addrummond/newlightmeter/kischematic/Readme.md

PChan MOSFET http://www.mouser.co.uk/ProductDetail/ROHM-Semiconductor/RZM001P02T2L/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
NChan http://www.mouser.co.uk/ProductDetail/ROHM-Semiconductor/RE1C002UNTCL/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

Low freq crystal: NX3215SA
High (16MHz) freq crystal: NX3225SA

USB-C connector protrusion above top layer: 0.475
USB-C connector protrusion above bottom layer: 2.265
USB-C total height: 3.34

EFM32 height: 0.85
BlueNRG-MS height: 0.85
BQ2971 height: 0.8
MMA8653FC height: 1.0
APDS-9303 height: 0.55
TPS62230: 0.65
Skyworks thing: 0.75
Inductor height: 1.0
Antenna height: 1.07
Dual MOSFET height: 0.9
EZMate thing: 1.4
Screen: 1.45
Zif connector height: 2
Low freq crystal: 0.9
High freq crystal: 0.55

Newest pair of crystals (available on Mouser):
http://www.mouser.co.uk/Search/ProductDetail.aspx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
http://www.mouser.co.uk/Search/ProductDetail.aspx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

Magic micro:

http://www.silabs.com/support%20documents/technicaldocs/efm32hg309.pdf

Suitable flat flex cable (cut in half):

http://www.digikey.co.uk/product-detail/en/molex-llc/0152660073/WM11348-ND/3160809

Side mount switch:

http://uk.rs-online.com/web/p/products/7856443/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|pcrid|88057077243|pkw||pmt||prd|7856443&gclid=Cj0KEQiAnIPDBRC7t5zJs4uQu5UBEiQA7u5Nez5Wsqkz7oU2pIy9AWAJCai1eRbfQIoq8IcizyYJO9QaAkB28P8HAQ

Useful info on EFM32 3-wire SPI:

http://community.silabs.com/t5/32-bit-MCU-Knowledge-Base/EFM32-as-a-3-wire-SPI-master/ta-p/123022

New dual MOSFET:

http://www2.mouser.com/ProductDetail/Infineon-Technologies/BSD840NH6327XTSA1/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

New buck:

http://www2.mouser.com/ProductDetail/Texas-Instruments/TPS62237DRYR/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

Low profile shileded inductor (1.0mm):

http://www2.mouser.com/ProductDetail/Bourns/SRP2010-1R0M/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

Old shielded inductor:

http://www2.mouser.com/ProductDetail/Sumida/CDRH2D18-HPNP-100NC/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
http://www.mouser.com/ds/2/390/cdrh2d18hp-339282.pdf

Old buck:

http://www2.mouser.com/ProductDetail/Texas-Instruments/LM3670MF-33-NOPB/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

USB-C midmount connector:

http://www.farnell.com/cad/1993947.pdf?_ga=1.47058095.988751352.1481488664

Notes on USB C configuration:

https://www.scorpia.co.uk/2016/03/17/using-usb-type-c-on-hobyist-projects/

3.2V LDO:

http://www2.mouser.com/ProductDetail/ROHM-Semiconductor/BU32TD3WG-TR/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

Little pogo pins:

http://www.digikey.co.uk/product-detail/en/mill-max-manufacturing-corp/0921-1-15-20-75-14-11-0/ED1655-ND/2784010

Trace impedance calc:

http://emclab.mst.edu/pcbtlc2/microstrip/

Trace thickness: 0.03556
Relative permittivity: 4.8
