addrummond/newlightmeter/bluenrg_notes/Readme.md

Some random notes on the BlueNRG and its SPI interface.

Start of a command packet signaled with 01.
Start of an event packet signaled with 04.

Some evidence that "04 0e 04 01 0c fc 00" is a normal response upon setting
device address:

<<<<<<< HEAD
    http://bbs.csdn.net/topics/391021421
=======
    https://www.google.co.uk/webhp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

Potentially useful info on correct sequence of startup commands (although
this is presumably being posted because it doesn't quite work):

http://bbs.csdn.net/topics/391021421

>>>>>>> 2c90545d739c9cc67405625468b59055c7635256
