addrummond/newlightmeter/kischematic/shopping.txt

5
http://www.mouser.co.uk/ProductDetail/Murata-Electronics/GRM155R60G106ME44D/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

3
http://www.mouser.co.uk/ProductDetail/TDK/C0402C0G1C470J020BC/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

17
http://www.mouser.co.uk/ProductDetail/AVX/01016D104KATUA/?qs=sGAEpiMZZMs0AnBnWHyRQAwkDkDzLNakJDHmuCcZvLc%3d

3
http://www.mouser.co.uk/ProductDetail/Kemet/C0402C103K8PACTU/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

1
http://www.mouser.co.uk/ProductDetail/AVX/02016D105KAT2A/?qs=sGAEpiMZZMs0AnBnWHyRQHzHPE94NOakZzFL8rkwtwk%3d

5
http://www.mouser.co.uk/ProductDetail/Taiyo-Yuden/AMK105BJ475MV-F/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

2
http://www.mouser.co.uk/ProductDetail/Taiyo-Yuden/JMK105BJ105MC-F/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

2
http://www.mouser.co.uk/ProductDetail/Wurth-Electronics/885012105012/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

1
http://www.mouser.co.uk/ProductDetail/AVX/04026D225KAT2A/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

2
http://www.mouser.co.uk/Search/ProductDetail.aspx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

2
http://www.mouser.co.uk/ProductDetail/Kemet/C0402C560J5GACTU/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

2
http://www.mouser.co.uk/ProductDetail/Wurth-Electronics/885012005056/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

2
http://www.mouser.co.uk/ProductDetail/Wurth-Electronics/885012005027/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

1
http://www.mouser.co.uk/ProductDetail/Murata-Electronics/GRM155R71C154KA12D/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

2
http://www.mouser.co.uk/ProductDetail/Wurth-Electronics/885012205055/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

4
http://www.mouser.co.uk/ProductDetail/Wurth-Electronics/885012105012/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

1
http://www.mouser.co.uk/ProductDetail/TE-Connectivity/2129691-1/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

3
http://www.mouser.co.uk/ProductDetail/Vishay/CRCW04020000Z0ED/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

1
http://www.mouser.co.uk/ProductDetail/FTDI/FT200XD-R/?qs=sGAEpiMZZMvVkErl6zY%252bqaOuKzgOTT%2fR

2
http://www.mouser.co.uk/ProductDetail/Yageo/RT0402FRE0727RL/?qs=sGAEpiMZZMtlubZbdhIBILzAkmRldA9hfCto7XdLxWU%3d

2
http://www.mouser.co.uk/ProductDetail/Yageo/RC0402FR-0710KL/?qs=sGAEpiMZZMtlubZbdhIBIPp9I5DmXL4oTFYHT01xAts%3d

1
http://uk.rs-online.com/web/p/tactile-switches/7856443/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

1
http://www.mouser.co.uk/ProductDetail/Panasonic/ERJ-2RKF2201X/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

3
http://www.mouser.co.uk/ProductDetail/Panasonic/ERJ-2RKF9102X/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

1
http://www.mouser.co.uk/ProductDetail/Infineon-Technologies/BSD840NH6327XTSA1/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

1
http://www.mouser.co.uk/ProductDetail/Texas-Instruments/BQ29702DSER/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

1
http://www.mouser.co.uk/ProductDetail/Texas-Instruments/TPS62237DRYR/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

1
http://www.mouser.co.uk/Search/ProductDetail.aspx?R=SRP2010-2R2Mvirtualkey65210000virtualkey652-SRP2010-2R2M

2
http://www.mouser.co.uk/ProductDetail/Murata-Electronics/LQP02HQ1N3C02E/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

1
http://www.mouser.co.uk/ProductDetail/Coilcraft/0603CS-5N6XJLU/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

2
http://www.mouser.co.uk/ProductDetail/Coilcraft/0603CS-3N9XGLU/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

**** TODO TRY TO FIND CHEAPER
1
http://www.mouser.co.uk/Search/ProductDetail.aspx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

4
http://www.mouser.co.uk/ProductDetail/Panasonic/ERJ-2RKF1001X/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

1
http://www.mouser.co.uk/ProductDetail/Silicon-Labs/EFM32ZG108F8-QFN24/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

1
http://www.mouser.co.uk/ProductDetail/CK-Components/KXT-131-LHS/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

2
http://www.mouser.co.uk/ProductDetail/Broadcom-Limited/APDS-9303-020/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

1
http://www.mouser.co.uk/ProductDetail/NXP-Freescale/MMA8653FCR1/?qs=sGAEpiMZZMuJJ6wbRIs2btaRRQKJJnyc

1
http://www.mouser.co.uk/ProductDetail/TE-Connectivity-Neohm/CPF0402B2K2E1/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

1
http://www.mouser.co.uk/ProductDetail/TE-Connectivity-Neohm/CPF0402B330RE1/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

1
http://www.mouser.co.uk/ProductDetail/Vishay/CRCW04022M70FKED/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

1
http://www.mouser.co.uk/ProductDetail/Vishay/CRCW04021M60FKED/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

1
http://www.mouser.co.uk/ProductDetail/STMicroelectronics/BLUENRG-MSQTR/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

1
http://www.mouser.co.uk/ProductDetail/Taiyo-Yuden/CBMF1608T4R7M/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

1
http://www.mouser.co.uk/ProductDetail/ABRACON/ABM3B-16000MHZ-10-1-U-T/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

1
http://www.mouser.co.uk/ProductDetail/ECS/ECS-327-125-34B-TR/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

1
http://www.mouser.co.uk/ProductDetail/Murata-Electronics/NCP18XH103F03RB/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

1
http://www.mouser.co.uk/ProductDetail/Panasonic/DZ2S068M0L/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

2
http://www.mouser.co.uk/ProductDetail/Wurth-Electronics/885012005011/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

*** NON STOCK ***
1
http://www.mouser.co.uk/ProductDetail/Skyworks/AAT3672IWO-42-1-T1/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
