addrummond/newlightmeter/kischematic/kischematic.kicad_pcb

## KiCad design kischematic/kischematic.kicad_pcb (2017-08-05)

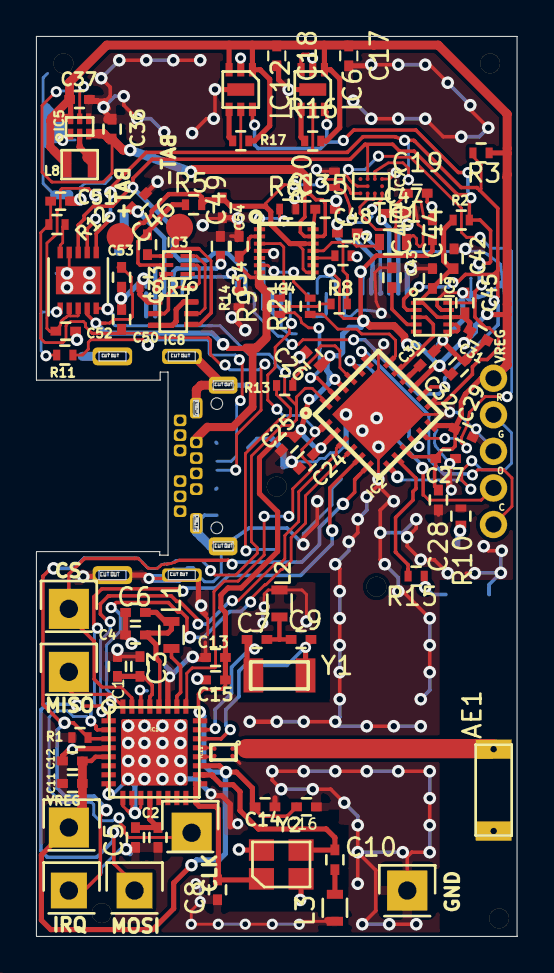
[picture p1: board kischematic.kicad_pcb from above]

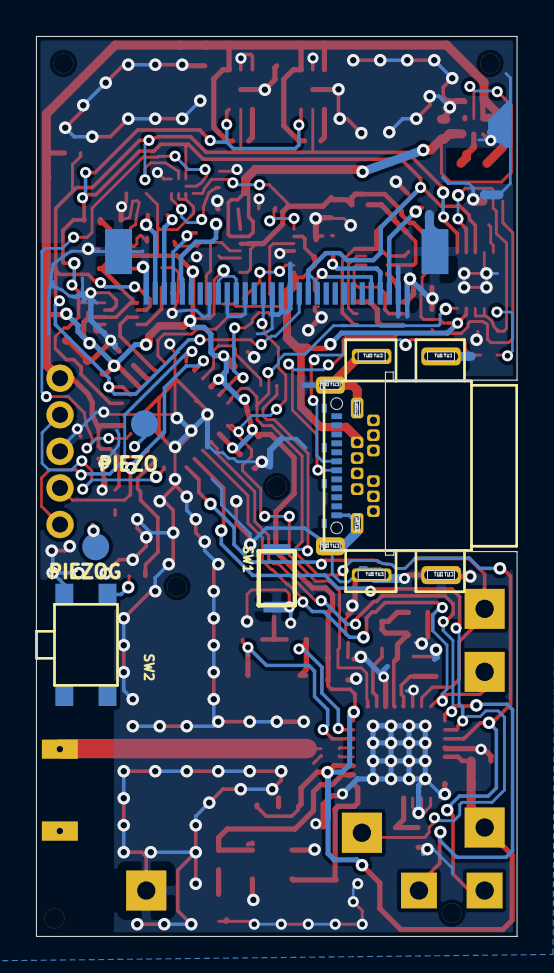
[picture p2: board kischematic.kicad_pcb from below]

Board: 2 copper layers, 26.7 x 50.0 mm, 108 parts (6 on the bottom side), 69 nets.

Parts:
AE1: Antenna_Dipole; AN2051
C1, C2: BY100p; C_0402
C3: BY150n; C_0402
C4: BY100n; C_0402
C5, C12, C14, C15: BYu1; C_0402
C6, C11, C13, C16: BY1u; C_0402
C7, C9: HP22p; C_0402
C8, C10: HP15p; C_0402
C17, C18, C19, C24, C26, C32, C33, C35, C43, C44, C45: u1; C_0402
C25, C28, C31, C34, C54: 10u; C_0402
C27, C29, C53: 10n; C_0402
C30, C42: 1u; C_0402
C36: BY 4u7; C_0402
C37: DC-DC 4u7; C_0402
C40, C47, C48: DC-DC 1u; C_0402
C46: DC-DC 2u2; C_0402
C49: 2u2; C_0402
C50, C51: 47p; C_0402
C52: 100n; C_0402
IC1: BlueNRG; QFN32
IC2: EFM32ZG108; QFN24
IC3: BQ297xx; WSON6
IC4: AAT3672IWO-4.2-1; AAT3672IWO
IC5: TPS6223xx
IC6, IC12: MAX44009
IC7: STC3115; STC3115IJT
IC8: BSD840NH6327XTSA1; SOT-363
IC9: MMA8653FC; DFN10
IC10: 128x64OLED; ER-OLED096-1
IC11: BALF-BRG-01D3; BALF-NRG-01D3
J1, J2, J3, J4, J5, J6: Screw_Terminal_1x01; M1.4MOUNTHOLE
L1: DC-DC 4u7; R_0603
L2, L3: 3n9; R_0603
L8: DC-DC 1u; SRP2010
P1, P2, P3, P4, P5, P6, P7: CONN_01X01; Pin_Header_Straight_1x01
R1, R8, R16, R17: 10k; R_0402
R2, R3, R13, R15: 1k; R_0402
R4: 2k2%; R_0402
R5: 330%; R_0402
R6: 2M7%; R_0402
R7: 1M6%; R_0402
R9, R11, R12, R21: 27R; R_0402
R10: 2k2; R_0402
R14: 91k; R_0402
R20: 50m%; R_0402
SW1: SW_Push; KXT131LHS
SW2: SW_Push; 434333045822
TH1: 10k; R_0603
TP1, TP2, TP3, TP4: TEST; SMALLWIREPAD
U1: USB-C; 2129691-1
U2: SWD_SPRING
U3: FT200XD; DFN-10-1EP_3x3mm_Pitch0.5mm
Y1: 32k; CRYSTAL3.2x1.5mm
Y2: 16M; CRYSTAL2.2x1.6

Connections:
ACCELINT1: IC2.17, IC9.3
ANT: AE1.1, IC11.1
BAT+: C54.1, IC4.8, IC4.12, IC7.A3, R5.2, TP3.1
BAT-: C33.1, IC3.4, IC8.4, TP4.1
BATD: IC2.11, IC7.B2
BNRG_SPI_CS: IC1.31, IC2.6, P5.1
BNRG_SPI_IRQ: IC1.3, IC2.24, P6.1, R1.1, U3.5
CHARGE_ENABLE: IC2.18, R21.1
DISPLAY_RESET: IC1.25, IC2.1, IC10.14
EFMRESET: IC2.7, U2.4
GND: C1.1, C2.2, C3.1, C4.1, C5.2, C6.1, C8.2, C11.2, C12.2, C13.1, C14.2, C15.1, C16.2, C17.2, C18.2, C19.2, C24.2, C25.2, C26.2, C27.1, C28.1, C29.2, C30.1, C31.1, C32.1, C34.1, C35.1, C36.2, C37.1, C40.2, C42.2, C43.1, C44.2, C45.1, C46.1, C49.1, C50.1, C51.1, C52.2, C53.1, C54.2, IC1.0, IC1.4, IC1.8, IC1.9, IC1.10, IC1.11, IC1.27, IC1.30, IC2.0, IC4.4, IC5.1, IC5.4, IC6.2, IC6.3, IC6.7, IC7.D1, IC8.1, IC9.6, IC9.7, IC9.9, IC10.1, IC10.8, IC10.10, IC10.12, IC10.15, IC10.16, IC10.17, IC10.29, IC10.30, IC10.31, IC10.32, IC11.2, IC12.2, IC12.7, L2.1, L3.2, P7.1, R1.2, R4.1, R6.1, R7.1, R10.2, R14.2, R20.2, SW1.2, SW2.2, TH1.1, U1.A1, U1.B1, U1.B12, U1.S1, U1.S2, U1.S3, U1.S4, U1.S5, U1.S6, U2.3, U3.9, U3.11, Y2.2, Y2.3
I2C_SCL: IC2.14, IC6.5, IC7.C1, IC9.2, IC10.18, IC12.5, R3.2, U3.6
I2C_SDA: IC2.13, IC6.6, IC7.B1, IC9.10, IC10.19, IC10.20, IC12.6, R2.2, U3.8
MAINBUTTON: IC2.21, R13.2
unnamed: C1.2, C3.2, IC1.29
unnamed: C2.1, C5.1, IC1.12
unnamed: C4.2, C6.2, IC1.28, L1.1
unnamed: C7.1, C9.1, L2.2
unnamed: C7.2, IC1.23, Y1.1
unnamed: C8.1, IC1.17, Y2.1
unnamed: C9.2, IC1.22, Y1.2
unnamed: C10.1, IC1.18, Y2.4
unnamed: C10.2, L3.1
unnamed: C30.2, IC2.16
unnamed: C33.2, IC3.5, R5.1
unnamed: C35.2, IC4.14
unnamed: C43.2, IC9.4
unnamed: C46.2, IC10.28
unnamed: C47.1, IC10.3
unnamed: C47.2, IC10.2
unnamed: C48.1, IC10.5
unnamed: C48.2, IC10.4
unnamed: C49.2, IC10.27
unnamed: C52.1, U3.2, U3.3, U3.7
unnamed: IC1.20, IC11.3
unnamed: IC1.21, IC11.4
unnamed: IC1.26, L1.2
unnamed: IC3.2, IC8.2
unnamed: IC3.3, IC8.5
unnamed: IC3.6, R4.2
unnamed: IC4.1, R6.2
unnamed: IC4.3, R9.2
unnamed: IC4.6, R21.2
unnamed: IC4.10, R7.2
unnamed: IC4.11, R8.2, TH1.2
unnamed: IC5.2, L8.1
unnamed: IC6.4, R16.1
unnamed: IC7.D3, R20.1
unnamed: IC8.3, IC8.6
unnamed: IC10.26, R14.1
unnamed: IC12.4, R17.1
unnamed: R11.2, U3.1
unnamed: R12.2, U3.10
unnamed: R13.1, SW1.1
unnamed: R15.1, SW2.1
PIEZO: IC2.10, TP1.1
PIEZOGND: R10.1, TP2.1
PSTAT1: IC2.23, R9.1
SECONDBUTTON: IC2.8, R15.2
SPI_CLK: IC1.2, IC2.5, P2.1
SPI_MISO: IC1.32, IC2.4, P3.1
SPI_MOSI: IC1.1, IC2.3, P4.1
SWCLK: IC2.19, U2.1
SWDIO: IC2.20, U2.2
USBD+: C50.2, C51.2, R12.1, U1.A6
USBD-: R11.1, U1.A7
VLOAD: C36.1, IC4.13, IC5.3, IC5.5
VREG: C11.1, C12.1, C13.2, C14.1, C15.2, C16.1, C17.1, C18.1, C19.1, C24.1, C25.1, C26.1, C27.2, C28.2, C29.1, C31.2, C32.2, C37.2, C40.1, C42.1, C44.1, C45.2, IC1.5, IC1.19, IC1.24, IC2.2, IC2.9, IC2.12, IC2.15, IC2.22, IC5.6, IC6.1, IC7.B3, IC7.C3, IC9.1, IC9.8, IC10.6, IC10.9, IC10.11, IC12.1, IC12.3, L8.2, P1.1, R2.1, R3.1, R16.2, R17.2, U2.5
VUSB: C34.2, C53.2, IC4.2, IC4.7, R8.1, U1.B4, U3.4
