addrummond/newlightmeter/(commit log)

2016-12-09 Init with schematic files.
    [kischematic.kicad_pcb, kischematic.sch]
2016-12-09 More work on initial layout.
    [kischematic.kicad_pcb, kischematic.sch]
2016-12-09 More bluetooth layout work.
    [kischematic.kicad_pcb]
2016-12-09 More work on bluetooth layout.
    [kischematic.kicad_pcb, kischematic.sch]
2016-12-10 Add some bypass caps etc.
    [kischematic.kicad_pcb]
2016-12-10 More work on layout.
    [kischematic.kicad_pcb, kischematic.sch]
2016-12-10 Some initial work on outline and ground pour.
    [kischematic.kicad_pcb]
2016-12-10 More work on ground polygons etc.
    [kischematic.kicad_pcb]
2016-12-10 More work on routing.
    [kischematic.kicad_pcb]
2016-12-10 More layout work.
    [kischematic.kicad_pcb]
2016-12-10 Get rid of discrete balun.
    [kischematic.kicad_pcb, kischematic.sch]
2016-12-10 Add antenna (integrated)
    [kischematic.kicad_pcb, kischematic.sch]
2016-12-10 Add discrete balun/matching newtork.
    [kischematic.kicad_pcb, kischematic.sch]
2016-12-10 Add antenna and copper pour keepout.
    [kischematic.kicad_pcb]
2016-12-10 Some attempts to fix stupid air wire issues.
    [kischematic.kicad_pcb]
2016-12-10 Ratsnest issue seems to have resolved itself.
    [kischematic.kicad_pcb]
2016-12-10 Add pin headers.
    [kischematic.kicad_pcb, kischematic.sch]
2016-12-10 Tidy up silkscreen.
    [kischematic.kicad_pcb]
2016-12-10 Some work on pads, but losing too much of ground polygon.
    [kischematic.kicad_pcb]
2016-12-10 Some attempts at ground isolation.
    [kischematic.kicad_pcb, kischematic.sch]
2016-12-10 More work on layout, ground, etc.
    [kischematic.kicad_pcb]
2016-12-10 Fix some ground issues.
    [kischematic.kicad_pcb]
2016-12-10 Most stuff now connected.
    [kischematic.kicad_pcb]
2016-12-10 Minor ground tweaks.
    [kischematic.kicad_pcb]
2016-12-10 DRC now ok (I think?)
    [kischematic.kicad_pcb]
2016-12-10 Some tweaks based on OSH preview of gerbers
    [kischematic.kicad_pcb]
2016-12-10 Some more tweaks.
    [kischematic.kicad_pcb]
2016-12-10 Attempt to resolve soldermask issue with BlueNRG IC.
    [kischematic.kicad_pcb]
2016-12-10 Trim board width to 26.7mm
    [kischematic.kicad_pcb]
2016-12-10 Fix soldermask issues.
    [kischematic.kicad_pcb, kischematic.sch]
2016-12-10 Some work on ground plane stiching.
    [kischematic.kicad_pcb]
2016-12-10 Fix DRC errors from stiching.
    [kischematic.kicad_pcb]
2016-12-10 Make some stray Ps invisible.
    [kischematic.kicad_pcb]
2016-12-10 Move VREG text slightly.
    [kischematic.kicad_pcb]
2016-12-10 Enlarge C16 text.
    [kischematic.kicad_pcb]
2016-12-10 More stiching.
    [kischematic.kicad_pcb]
2016-12-10 Slightly more stitching.
    [kischematic.kicad_pcb]
2016-12-11 Some initial work on the rest of the circuit.
    [kischematic.kicad_pcb, kischematic.sch]
2016-12-11 Add footprint for power management IC.
2016-12-11 Add schematic symbol for power management IC.
2016-12-11 Initial work adding power management IC to schematic.
    [kischematic.sch]
2016-12-11 Add schematic and footprint for lipo protection IC.
2016-12-11 Add LIPO protection circuit.
    [kischematic.kicad_pcb, kischematic.sch]
2016-12-11 More work adding various components.
    [kischematic.kicad_pcb, kischematic.sch]
2016-12-11 Add some additional footprints.
2016-12-11 Switch to TI buck converter (fewer components and better docs re layout)
    [kischematic.sch]
2016-12-11 Add circuit for light sensors to schematic
    [kischematic.kicad_pcb, kischematic.sch]
2016-12-11 Some initial work on horrible USB-C connector footprint.
2016-12-11 Work on physical layout of USB-C connector essentially complete
2016-12-11 Finish pin assignment for USB-C connector
2016-12-11 Fix to USB-C connector layout.
2016-12-11 Start adding USB-C connector to design. Some DRC issues.
    [kischematic.kicad_pcb, kischematic.sch]
2016-12-11 Make design rules more permissive; still a few errors from USB-C conn.
    [kischematic.kicad_pcb]
2016-12-11 Tweak USB-C connector layout to meet new design rules.
    [kischematic.kicad_pcb]
2016-12-12 Add ground connection to shield.
    [kischematic.kicad_pcb, kischematic.sch]
2016-12-12 Add main pushbutton switch.
    [kischematic.kicad_pcb, kischematic.sch]
2016-12-12 Some preliminary work on layout.
    [kischematic.kicad_pcb]
2016-12-12 Mirror USB conn
    [kischematic.kicad_pcb]
2016-12-12 Some issues with screen placement.
    [kischematic.kicad_pcb]
2016-12-12 Some work on making room for screen.
    [kischematic.kicad_pcb]
2016-12-12 Add cutout for USB.
    [kischematic.kicad_pcb]
2016-12-12 Some work on GND polygons.
    [kischematic.kicad_pcb]
2016-12-12 Approximate placement of some remaining components.
    [kischematic.kicad_pcb]
2016-12-12 Fix whack usb footprint.
    [kischematic.kicad_pcb]
2016-12-12 Wire power mux.
    [kischematic.kicad_pcb]
2016-12-12 Some more work on buck layout.
    [kischematic.kicad_pcb, kischematic.sch]
2016-12-12 More work on buck layout. Seems complete now.
    [kischematic.kicad_pcb]
2016-12-12 Lower ground plane connectivity.
    [kischematic.kicad_pcb]
2016-12-12 Add low profile battery connector 503763-0291 footprint.
2016-12-12 Some fiddling around with arrangements.
    [kischematic.kicad_pcb, kischematic.sch]
2016-12-12 More routing.
    [kischematic.kicad_pcb, kischematic.sch]
2016-12-12 Improve ground connectivity.
    [kischematic.kicad_pcb]
2016-12-13 Some fiddly SPI routing.
    [kischematic.kicad_pcb]
2016-12-13 Some additional fiddly routing.
    [kischematic.kicad_pcb]
2016-12-13 Some progress on extremely fiddly routing.
    [kischematic.kicad_pcb, kischematic.sch]
2016-12-13 All SPI lines now routed to BlueNRG.
    [kischematic.kicad_pcb]
2016-12-13 Initial work on SWD connection.
    [kischematic.kicad_pcb, kischematic.sch]
2016-12-13 Tweak programming header.
    [kischematic.kicad_pcb]
2016-12-13 Add accelerometer footprint and schematic.
    [kischematic.kicad_pcb]
2016-12-13 Add accelerometer to schematic.
    [kischematic.kicad_pcb, kischematic.sch]
2016-12-14 Insane USB-C routing issues.
    [kischematic.kicad_pcb]
2016-12-14 Impedance issues
    [kischematic.kicad_pcb]
2016-12-14 Add bypass caps for uc.
    [kischematic.kicad_pcb]
2016-12-14 Some ground/routing progress.
    [kischematic.kicad_pcb]
2016-12-14 Some work on ground etc.
    [kischematic.kicad_pcb]
2016-12-14 Connect VREG.
    [kischematic.kicad_pcb]
2016-12-15 More work
    [kischematic.kicad_pcb]
2016-12-15 More stuff.
    [kischematic.kicad_pcb]
2016-12-15 Add OLED schematic and footprint.
    [kischematic.kicad_pcb, kischematic.sch]
2016-12-15 Some progress on USB routing.
    [kischematic.kicad_pcb, kischematic.sch]
2016-12-15 More tweaks.
    [kischematic.kicad_pcb]
2016-12-16 All comoponents now placed on board except display header.
    [kischematic.kicad_pcb]
2016-12-16 Routing with display header in mind.
    [kischematic.kicad_pcb]
2016-12-16 Initial placement of screen header.
    [kischematic.kicad_pcb]
2016-12-16 Some work on screen schematic.
    [kischematic.sch]
2016-12-16 Some more screen routing issues.
    [kischematic.kicad_pcb]
2016-12-16 More work on I2C screen routing.
    [kischematic.kicad_pcb]
2016-12-16 More routing work.
    [kischematic.kicad_pcb]
2016-12-17 Some work on tidying up silkscreen.
    [kischematic.kicad_pcb]
2016-12-17 Fix a few DRC violations.
    [kischematic.kicad_pcb]
2016-12-17 Remove LDO
    [kischematic.kicad_pcb, kischematic.sch]
2016-12-17 Some tweaks to ground polygons.
    [kischematic.kicad_pcb]
2016-12-17 Fix DRC errors.
    [kischematic.kicad_pcb, kischematic.sch]
2016-12-17 Routing tweaks.
    [kischematic.kicad_pcb]
2016-12-17 All connected, no DRC errors (spurious 'unconnected' warning from jumper)
    [kischematic.kicad_pcb]
2016-12-17 One more cap to place.
    [kischematic.kicad_pcb, kischematic.sch]
2016-12-17 Place final cap.
    [kischematic.kicad_pcb]
2016-12-17 Some work on silkscreen.
    [kischematic.kicad_pcb]
2016-12-17 Some improvements to ground polygon connectivity.
    [kischematic.kicad_pcb]
2016-12-17 Improvement to ground polygon connectivity.
    [kischematic.kicad_pcb]
2016-12-17 Further improvements to ground polygon connectivity.
    [kischematic.kicad_pcb]
2016-12-17 More ground stuff.
    [kischematic.kicad_pcb]
2016-12-17 Minor stuff.
    [kischematic.kicad_pcb]
2016-12-18 Add extra button.
    [kischematic.kicad_pcb, kischematic.sch]
2016-12-18 Add mounting holes.
    [kischematic.kicad_pcb, kischematic.sch]
2016-12-18 Some tweaks to silkscreen.
    [kischematic.kicad_pcb]
2016-12-19 Add lower profile buck convertor to lib.
    [kischematic.sch]
2016-12-19 Finish layout for new buck convertor.
    [kischematic.kicad_pcb, kischematic.sch]
2016-12-19 Some initial work on new battery protection IC.
    [kischematic.kicad_pcb, kischematic.sch]
2016-12-19 Almost done with new power ICs.
    [kischematic.kicad_pcb, kischematic.sch]
2016-12-19 New power stuff now routed.
    [kischematic.kicad_pcb]
2016-12-20 Tweaks to ground.
    [kischematic.kicad_pcb]
2016-12-20 Important fix -- add accidentally removed via.
    [kischematic.kicad_pcb]
2016-12-20 More ground polygon stuff.
    [kischematic.kicad_pcb]
2016-12-20 Preparatory work for routing piezo pads.
    [kischematic.kicad_pcb]
2016-12-20 Experimentation with FFC for screen.
    [kischematic.kicad_pcb, kischematic.sch]
2016-12-20 In progress.
    [kischematic.kicad_pcb, kischematic.sch]
2016-12-20 Initial work on screen SPI connection.
    [kischematic.kicad_pcb]
2016-12-20 Some significant progress on display connector routing.
    [kischematic.kicad_pcb]
2016-12-21 Some possible small steps of routing progress.
    [kischematic.kicad_pcb]
2016-12-21 More routing tweaks.
    [kischematic.kicad_pcb]
2016-12-21 Some further routing tweaks.
    [kischematic.kicad_pcb, kischematic.sch]
2016-12-21 Getting there with the routing...
    [kischematic.kicad_pcb]
2016-12-21 Further routing tweaks.
    [kischematic.kicad_pcb, kischematic.sch]
2016-12-23 Further routing progress; three wire SPI for screen.
    [kischematic.kicad_pcb, kischematic.sch]
2016-12-23 Some more routing work.
    [kischematic.kicad_pcb]
2016-12-23 Note on 3-wire SPI.
2016-12-23 Routing for first connector point essentially complete.
    [kischematic.kicad_pcb, kischematic.sch]
2016-12-23 Display now routed again.
    [kischematic.kicad_pcb]
2016-12-23 Fix minor GND routing issue.
    [kischematic.kicad_pcb]
2016-12-23 GND tweak.
    [kischematic.kicad_pcb]
2016-12-23 Add crude battery voltage measurement schematic to circuit.
    [kischematic.kicad_pcb, kischematic.sch]
2016-12-23 Simplify bat voltage thing.
    [kischematic.kicad_pcb, kischematic.sch]
2016-12-24 Fix weird issue.
    [kischematic.kicad_pcb, kischematic.sch]
2016-12-25 Fix some DRC errors.
    [kischematic.kicad_pcb, kischematic.sch]
2016-12-25 Connect accelerometer interrupt.
    [kischematic.kicad_pcb, kischematic.sch]
2016-12-26 Fix unconnected nets.
    [kischematic.kicad_pcb]
2016-12-26 Add piezo resistor.
    [kischematic.kicad_pcb, kischematic.sch]
2016-12-26 Add side button.
    [kischematic.kicad_pcb]
2016-12-26 Add note on side mount switch.
    [kischematic.kicad_pcb]
2016-12-26 Get central switch on bottom layer.
    [kischematic.kicad_pcb]
2016-12-26 Add piezo pads.
    [kischematic.kicad_pcb, kischematic.sch]
2016-12-26 GND tweaks.
    [kischematic.kicad_pcb]
2016-12-27 Silk screen tweaks.
    [kischematic.kicad_pcb]
2016-12-27 Attempt to fix some issues with USB-C connector.
    [kischematic.kicad_pcb]
2016-12-27 Remove arcs from outline
    [kischematic.kicad_pcb]
2016-12-27 Add cutouts for usb-c pads.
    [kischematic.kicad_pcb]
2016-12-27 Fix some unconnected errors.
    [kischematic.kicad_pcb]
2016-12-27 Layout tweaks.
    [kischematic.kicad_pcb]
2016-12-27 Change antenna footprint to allow mounting on either side for testing purposes
    [kischematic.kicad_pcb]
2016-12-28 Add BlueNRG datasheet that has 3nH inductors in schematic
2016-12-28 Impedance tweak. http://www.hughescircuits.com/index.php/en/support/impedance-calculator
    [kischematic.kicad_pcb]
2016-12-28 Ground connectivity.
    [kischematic.kicad_pcb]
2016-12-28 Add some missing edge cuts.
    [kischematic.kicad_pcb]
2016-12-28 Silkscreen tweaks.
    [kischematic.kicad_pcb]
2016-12-28 Note high performance capacitors in values.
    [kischematic.sch]
2016-12-28 Correct DC-DC inductor value for BlueNRG.
    [kischematic.sch]
2016-12-28 Some more component value annotations.
    [kischematic.sch]
2016-12-28 Routing problem caused by diode change; fix missing edge cuts.
    [bom.csv, kischematic.kicad_pcb, kischematic.sch]
2016-12-29 More work on USB stuff.
    [kischematic.kicad_pcb, kischematic.sch]
2016-12-29 Remove unnecessary (I hope) D+/- connection.
    [kischematic.kicad_pcb, kischematic.sch]
2016-12-29 Remove more (hopefully) unnecessary USB connections.
    [kischematic.kicad_pcb, kischematic.sch]
2016-12-29 More USB work.
    [kischematic.kicad_pcb, kischematic.sch]
2016-12-29 Before routing attempt.
    [kischematic.kicad_pcb, kischematic.sch]
2016-12-29 give up on external usb thingy
    [kischematic.kicad_pcb, kischematic.sch]
2016-12-29 Remove huge dead trace.
    [kischematic.kicad_pcb]
2016-12-29 Oh dear...
    [kischematic.kicad_pcb, kischematic.sch]
2016-12-30 Good progress on routing USB thing.
    [kischematic.kicad_pcb, kischematic.sch]
2016-12-30 Some good progress routing USB chip.
    [kischematic.kicad_pcb]
2016-12-31 Finished routing I2C USB thing.
    [kischematic.kicad_pcb]
2016-12-31 silk screen tweaks
    [kischematic.kicad_pcb]
2017-01-01 Initial work on routing USB interrupt.
    [kischematic.kicad_pcb]
2017-01-01 Minor routing miracle.
    [kischematic.kicad_pcb, kischematic.sch]
2017-01-01 Remove apparently spurious 'unconnected' warning.
    [kischematic.kicad_pcb]
2017-01-01 Remove unnecessary via in bluetooth layout.
    [kischematic.kicad_pcb, kischematic.sch]
2017-01-01 Some initial PSTAT1 routing work.
    [kischematic.kicad_pcb, kischematic.sch]
2017-01-01 Finish PSTAT1 routing (via jumper so can be removed if it causes problems)
    [kischematic.kicad_pcb, kischematic.sch]
2017-01-01 Fix some missing/wrong value caps in power management IC circuit.
    [kischematic.kicad_pcb, kischematic.sch]
2017-01-01 Layout complete?
    [kischematic.kicad_pcb]
2017-01-02 Add missing 'cut' annotations.
    [kischematic.kicad_pcb]
2017-01-02 Add gerbers to be made by PCBway.
    [kischematic.kicad_pcb]
2017-01-02 Updated PCB in response to issues raised by PCBway with cutout overlapping trace
    [kischematic.kicad_pcb]
2017-01-02 Some work on BOM shopping list.
    [bom.csv, kischematic.sch]
2017-01-02 Finish first-pass BOM shopping list.
    [kischematic.sch]
2017-01-03 Another fix in response to PCBway query.
    [kischematic.kicad_pcb]
2017-01-03 Add missing item to bom shopping list.
2017-01-03 More changes in response to PCBway requests.
    [kischematic.kicad_pcb, kischematic.sch]
2017-01-03 Remove dead track.
    [kischematic.kicad_pcb]
2017-01-03 More changes based on PCBway requests.
    [kischematic.kicad_pcb]
2017-01-03 Another round of gerber modification for PCBway
2017-01-03 Minor trace move.
    [kischematic.kicad_pcb]
2017-01-03 Minor improvements to GND.
    [kischematic.kicad_pcb]
2017-01-04 Add pogo pin things to list.
2017-01-05 Some work on trying mouser instead of digikey.
    [kischematic.sch]
2017-01-05 Mouser shopping list now essentially complete.
    [kischematic.sch]
2017-01-09 Some minor tweaks to USB connector based on first PCB prototype.
    [kischematic.kicad_pcb]
2017-01-14 Move/remove badly positioned case screw holes.
    [kischematic.kicad_pcb, kischematic.sch]
2017-01-16 Some changes to USB connector layout based on experience with prototype board
    [kischematic.kicad_pcb]
2017-01-16 Another USB connector tweak.
    [kischematic.kicad_pcb]
2017-01-17 Fix bizarre mistake where I misinterpreted USB SMD pads as through holes.
    [kischematic.kicad_pcb]
2017-01-18 Need access to BlueNRG reset pin (not routed yet).
    [kischematic.kicad_pcb, kischematic.sch]
2017-01-22 Fix stupid missing connection in BlueNRG buck circuit which stopped everything working
    [kischematic.kicad_pcb, kischematic.sch]
2017-01-23 Route BlueNRG reset signal and some other routing tweaks.
    [kischematic.kicad_pcb]
2017-01-25 Set SPI speed in call to init function.
2017-01-25 Some progress on making SPI communication more reliable.
2017-01-26 SPI communication appears to be working reliably now.
2017-01-27 Add GATT_Init command to sequence and make SPI communication yet more reliable
2017-01-27 Weird problem with GAP_Init.
    [test.c]
2017-01-27 Can now set discoverable, but can't find device.
2017-01-29 Thinking about using discrete balun.
    [kischematic.kicad_pcb, kischematic.sch]
2017-02-02 Remove some unnecessary vias and an unnecessary jumper.
    [kischematic.kicad_pcb, kischematic.sch]
2017-02-02 Reduce solder mask clearence for balun pads.
    [kischematic.kicad_pcb]
2017-02-02 Remove another jumper.
    [kischematic.kicad_pcb, kischematic.sch]
2017-02-02 Some work on layout with discrete balun.
    [kischematic.kicad_pcb]
2017-02-03 Simple main.c programmed successfully for first test board.
2017-02-04 Somewhat working accel I2C code.
    [kischematic.kicad_pcb]
2017-02-04 Some pretty much working accel i2c code.
2017-02-04 Some initial work on using better light sensors.
    [kischematic.kicad_pcb, kischematic.sch]
2017-02-04 Tidying up.
    [kischematic.kicad_pcb]
2017-02-04 Some work on pcb layout for new sensors.
    [kischematic.kicad_pcb]
2017-02-04 Some layout improvements.
    [kischematic.kicad_pcb]
2017-02-04 Some tweaks to USB-C layout.
    [kischematic.kicad_pcb]
2017-02-04 Remove unnecessary vias.
    [kischematic.kicad_pcb]
2017-02-04 Remove another unnecessary via.
    [kischematic.kicad_pcb]
2017-02-04 More via removal.
    [kischematic.kicad_pcb, kischematic.sch]
2017-02-05 Some preparatory work for repositioning screen and using I2C instead of SPI.
    [kischematic.kicad_pcb, kischematic.sch]
2017-02-05 Remove some dead traces.
    [kischematic.kicad_pcb]
2017-02-05 Some initial work on layout for repositioned screen.
    [kischematic.kicad_pcb, kischematic.sch]
2017-02-05 More work on new screen layout.
    [kischematic.kicad_pcb]
2017-02-05 Finished placing screen components.
    [kischematic.kicad_pcb]
2017-02-05 Update layout for zif screen connector.
    [kischematic.kicad_pcb]
2017-02-05 More work on repositioned screen.
    [kischematic.kicad_pcb, kischematic.sch]
2017-02-05 More work on screen layout.
    [kischematic.kicad_pcb, kischematic.sch]
2017-02-05 Remove some dead tracks.
    [kischematic.kicad_pcb]
2017-02-05 Move light sensors to center
    [kischematic.kicad_pcb]
2017-02-06 Some tweaks to BlueNRG layout.
    [kischematic.kicad_pcb]
2017-02-06 Some more work on BlueNRG layout.
    [kischematic.kicad_pcb]
2017-02-06 Work on BlueNRG crystals.
    [kischematic.kicad_pcb]
2017-02-06 Balun layout tweaks.
    [kischematic.kicad_pcb]
2017-02-06 Some via stiching work.
    [kischematic.kicad_pcb]
2017-02-06 More ground stiching work.
    [kischematic.kicad_pcb]
2017-02-06 Some ground polygon improvements.
    [kischematic.kicad_pcb]
2017-02-07 Add various footprints that I forgot to add to repo.
    [kischematic.sch]
2017-02-07 Some initial work on integrating lipo gass gauge.
    [kischematic.sch]
2017-02-07 Screen layout tweaks.
    [kischematic.kicad_pcb, kischematic.sch]
2017-02-07 Add footprints for MOSFET and associated gas gauge.
    [kischematic.kicad_pcb]
2017-02-07 Update to gass gauge circuit.
    [kischematic.sch]
2017-02-07 Update battery fuel gauge circuit.
    [kischematic.sch]
2017-02-07 Some initial work on making room for fuel gauge.
    [kischematic.kicad_pcb]
2017-02-07 Initial work on layout of battery gauge.
    [kischematic.kicad_pcb]
2017-02-07 Connect charge enable pin of skyworks IC to EFM32 (via small R jumper)
    [kischematic.kicad_pcb, kischematic.sch]
2017-02-07 Fix via stiching mess at bottom of board.
    [kischematic.kicad_pcb]
2017-02-07 More bat work.
    [kischematic.sch]
2017-02-07 More work on routing BATD.
    [kischematic.kicad_pcb, kischematic.sch]
2017-02-07 Remove unused components.
    [kischematic.sch]
2017-02-07 Gnd connectivity.
    [kischematic.kicad_pcb]
2017-02-07 Finished some very nasty routing.
    [kischematic.kicad_pcb]
2017-02-07 More work on gauge routing.
    [kischematic.kicad_pcb]
2017-02-07 Finish gauge routing!
    [kischematic.kicad_pcb, kischematic.sch]
2017-02-08 Fix some DRC violations.
    [kischematic.kicad_pcb]
2017-02-08 All DRC violations fixed.
    [kischematic.kicad_pcb]
2017-02-08 Fix some spurious and non-spurious unconnected errors.
    [kischematic.kicad_pcb]
2017-02-08 More work on gnd plane.
    [kischematic.kicad_pcb]
2017-02-08 Longer tail for thermistor GND connection.
    [kischematic.kicad_pcb]
2017-02-09 Remove overly long pads on dual mosfet ic.
    [kischematic.kicad_pcb]
2017-02-09 Add SOT-416FL footprint.
2017-02-16 Add possibly usefuly hole to help with mounting center button.
    [kischematic.kicad_pcb, kischematic.sch]
2017-08-01 Some tweaks to tracks on pcb
    [kischematic.kicad_pcb]
2017-08-05 Updates to rpi spi bluenrg test code.
